guoqinghao/SmartCar/SC-Code/平衡车FreeRTOS/readme.txt

接线说明
编码器1:    PA0 PA1
编码器2:    PB6 PB7
陀螺仪:     SCL PC8
            SDA PC9
            AD0 PC7
            INT  PC6
PWM1,2:     PA6 PA7 
PWM3,4:     PB0 PB1
电压检测:   PC4
电机检测:   PA2
开机锁定:   PA3
串口TXD1:   PA9
串口RXD1:   PA10
串口TXD2:   PD5
串口RXD2:   PD6
串口TXD3:   PB10
串口RXD3:   PB11
按键中断:   PA4
心跳LED:    PA5
