guoqinghao/SmartCar/SC-PCB/Smart-Car-Core/Smart-Car.xlsx

 | Comment | Description | Designator | Footprint | LibRef | Quantity
 | 0.1μF | 0.1μF_50V,X7R,±5% | C1, C2, C3, C4, C5, C6, C9, C11, C13, C14, C15, C17, C23, C25, C35, C44, C56 | 0603C | Cap_0.1μF_50V_0603 | 17
 | 20pF | 20pF_50V,CH,±5% | C7, C8 | 0603C | Cap_20pF_50V_0603 | 2
 | 10μF | 10μF_35V,X5R,20% | C10, C12, C16, C22, C30, C32, C33, C39, C41, C42, C65 | 0603C | Cap_10μF_35V_0603 | 11
 | 39pF | 39pF_50V,C0G (EIA),±1% | C18, C20, C46, C52, C54, C59 | 0603C | Cap_39pF_50V_0603 | 6
 | 2.2μF | 2.2μF_35V,±10% | C19 | 0603C | Cap_2.2uF_35V_0603 | 1
 | 10nF | 10nF_50V,SL_0603,±5%, 10nF/16V,0603 | C21, C38 | 0603C | Cap_10nF_50V_0603, Cap_10nF_16V_0603 | 2
 | 0.01μF | 0.01μF_50V,C0G,5% | C24, C36, C45 | 0603C | Cap_0.01μF_50V_0603 | 3
 | 10μF | 10μF_10V,10% | C26 | 1206C | Cap_10μF_10V_1206 | 1
 | 4.7μF | 4.7μF_35VJB,±10% | C27, C28 | 1206C | Cap_4.7μF_35V_1206 | 2
 | 100μF | 100μF_16V | C29 | D7343C | Cap_100μF_16V_D7343 | 1
 | 470pf | 470pf_50V,X7R,10% | C31, C34, C40, C43 | 0603C | Cap_470pf_50V_0603 | 4
 | 100nf | 100nf_50V,X5R,10% | C37 | 0603C | Cap_100nf_50V_0603 | 1
 | 1μF | 1μF_50V,X5R,±10% | C47, C48, C49, C50, C51, C53, C55, C57, C58, C60, C61, C63, C64, C66 | 0603C | Cap_1μF_50V_0603 | 14
 | 0.15μF | 0.15μF_50V,X7R,±5% | C62 | 0603C | Cap_0.15μF_50V_0603 | 1
 | 蓝色LED | 蓝色LED | D1, D7 | 0603LED | 蓝色LED | 2
 | 1N5822 SS34 | 1N5822 SS34 | D2 | SMA-small | 1N5822 SS34_SMA | 1
 | 绿色LED | 蓝色LED | D3 | 0603LED | 蓝色LED | 1
 | 1N4148 | 1N4148WS | D4, D5 | SOD323 | 1N4148WS_SOD323 | 2
 | 红色LED | 蓝色LED | D6 | 0603LED | 蓝色LED | 1
 | 1N5819 SS14 | 1N5819 SS14 | D8 | SMA-small | 1N5819 SS14_SMA | 1
 | ESD5Z5.0T1G | ESD5Z5.0T1G | ESD1, ESD2, ESD6, ESD7, ESD8, ESD9 | SOD523 | ESD5Z5.0T1G_SOD523 | 6
 | ESD5Z6.0T1G | ESD5Z6.0T1G | ESD3, ESD5 | SOD523 | ESD5Z6.0T1G_SOD523 | 2
 | ESD5Z3.3T1G | ESD5Z3.3T1G | ESD4 | SOD523 | ESD5Z3.3T1G_SOD523 | 1
 | 轻触按键贴片 6*6*5 | 轻触按键贴片 6*6*5 | K1 | 轻触按键贴片 6*6*5 | 轻触按键贴片 6*6*5 | 1
 | BEAD-220/100MHZ | BEAD-220/100MHZ | L1, L2 | 0603R | BEAD-220/100MHZ_0603 | 2
 | 10μH_4A_7*7*3 | 10μH_4A | L3 | 7*7*3mm - 06030 | 10μH_4A_7*7*3 | 1
 | Header 5 | Header, 5-Pin | P1 | HDR1X5 | Header 5 | 1
 | Header 6 | Header, 6-Pin | P2, P3 | HDR1X6 | Header 6 | 2
 | Header 3 | Header, 3-Pin | P4 | HDR1X3 | Header 3 | 1
 | Header 2 | Header, 2-Pin | P5, P11 | HDR1X2 | Header 2 | 2
 | FPC-24P-0.5mm | FPC-24P-0.5mm | P6 | FPC24-0.5mm | FPC-24-0.5mm | 1
 | CA-C03 | CA-C03 | P8 | ANT | CA-C03 | 1
 | 预留测试口-2Pin | 预留测试口-2Pin | P9 | 预留测试口 2Pin | 预留测试口-2Pin | 1
 | Mini SD | Mini SD | P10 | TF-tan | Mini SD | 1
 | SI2323DS | SI2323DS | Q1 | SOT-23 | SI2323DS | 1
 | MMBT3904 | MMBT3904 | Q2 | SOT-23 | MMBT3904 | 1
 | 10K ohm | 10K ohm,1% | R1, R2, R3, R14, R18, R21, R22, R23, R27, R30, R47 | 0603R | Res_10K ohm_0603 | 11
 | 1M ohm | 1M ohm,1% | R4 | 0603R | Res_1M ohm_0603 | 1
 | 0 ohm | 0 ohm,5% | R5, R6, R7, R37, R50, R51 | 0603R | Res_0 ohm_0603 | 6
 | 4.7K ohm | 4.7K ohm,1% | R8, R11 | 0603R | Res_4.7K ohm_0603 | 2
 | 120ohm | 120 ohm_5% | R9, R12, R13, R16 | 0603R | Res_120ohm_0603 | 4
 | 200K ohm | 200K ohm,1% | R10 | 0603R | Res_200K ohm_0603 | 1
 | 68K ohm | 68K ohm,1% | R15 | 0603R | Res_68K ohm_0603 | 1
 | 100ohm | 100 ohm_5% | R17, R19, R36, R38, R41, R42 | 0603R | Res_100ohm_0603 | 6
 | 1K ohm | 1K ohm,1% | R20, R29, R32, R35, R40 | 0603R | Res_1K ohm_0603 | 5
 | 3K ohm | 3K ohm,1% | R24 | 0603R | Res_3K ohm_0603 | 1
 | 240ohm | 240ohm,1% | R25 | 0603R | Res_240ohm_0603 | 1
 | 100Kohm | 100K ohm_1%, 100K ohm_5% | R26, R31, R33 | 0603R | Res_100Kohm_0603 | 3
 | 330K ohm | 330K ohm,1% | R28, R34 | 0603R | Res_330K ohm_0603 | 2
 | 22K ohm | 22K ohm,1% | R39 | 0603R | Res_22K ohm_0603 | 1
 | 3.3K ohm | 3.3K ohm,1% | R43, R44, R45 | 0603R | Res_3.3K ohm_0603 | 3
 | 4.7ohm | 4.7ohm,1% | R46 | 0603R | Res_4.7ohm_0603 | 1
 | 39K ohm | 39K ohm,1% | R48 | 0603R | Res_39K ohm_0603 | 1
 | 0 ohm | 0 ohm,5% | R49 | 0805R | Res_0 ohm_0805 | 1
主芯片 | STM32F103VET6 | STM32F103VET6 | U1 | LQFP100 | STM32F103VET6 | 1
陀螺仪芯片 | MPU6050 | MPU6050 | U2 | QFN24 | MPU6050 | 1
 | DRV8833PWPR | DRV8833PWPR | U3 | TSSOP16 | DRV8833PWPR | 1
 | TPS5430DDAR | TPS5430DDAR | U4 | SOIC8-PAD | TPS5430DDAR | 1
 | TP2019-3.3YN5 | TP2019-3.3YN5 | U5, U6 | SOT-23-5 | TP2019-3.3YN5 | 2
 | KT1025A | KT1025A | U7 | SSOP24 | KT1025A | 1
 | BY8002-24SS | BY8002-24SS | U8 | QSOP-24N | BY8002-24SS | 1
 | MIX2002 | MIX2002 | U9 | SOP8 - NO-HP | MIX2002 | 1
 | XTAL_8MHz_5032 | XTAL_8MHz | Y1 | 5032 | XTAL_8MHz_5032 | 1
 | M49SMD-24M | M49SMD-24M | Y2 | M49S | M49SMD-24M-10ppm | 1
电机 | N20
