guoqinghao/SmartCar/SC-Model/PCB/Smart-Car.step

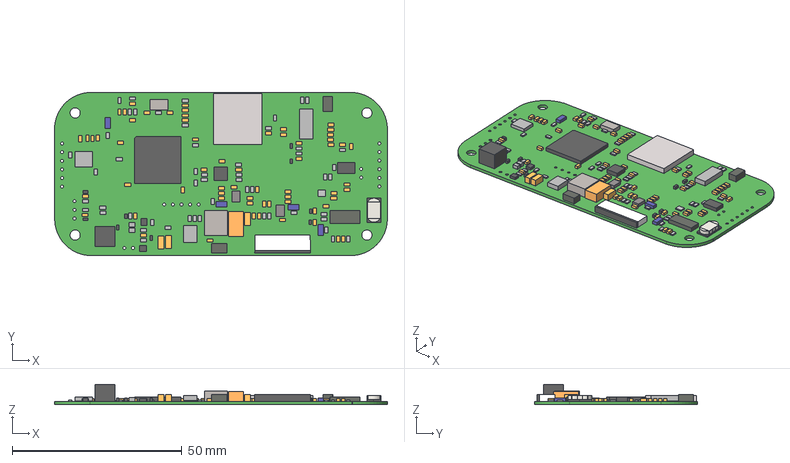
[picture p1: CAD file, 2023-08-29]
SC-Model/PCB/Smart-Car.step
98.2 x 48.1 x 6.00 mm
Extruded x 155
