guoqinghao/SmartCar/(list of files, drawings)

Other design files:
SC-PCB/SC_by_Iceda/Extend.SchDoc
SC-PCB/SC_by_Iceda/KT1025A.SchDoc
SC-PCB/SC_by_Iceda/MCU.SchDoc
SC-PCB/SC_by_Iceda/Module.SchDoc
SC-PCB/SC_by_Iceda/Power.SchDoc
SC-PCB/SC_by_Iceda/Smart-Car.PcbDoc
SC-PCB/SC_by_Iceda/Voice.SchDoc
SC-PCB/Smart-Car-Board/Extend.SchDoc
SC-PCB/Smart-Car-Board/Smart-Car.PrjPcb
SC-PCB/Smart-Car-Core/Extend.SchDoc
SC-PCB/Smart-Car-Core/KT1025A.SchDoc
SC-PCB/Smart-Car-Core/MCU.SchDoc
SC-PCB/Smart-Car-Core/Module.SchDoc
SC-PCB/Smart-Car-Core/Power.SchDoc
SC-PCB/Smart-Car-Core/Smart-Car.PrjPcb
SC-PCB/Smart-Car-Core/Voice.SchDoc
