guoqinghao/SmartCar/SC-Code/平衡车FreeRTOS/HARDWARE/MY_TASK/my_task.h

#ifndef __MY_TASK_H
#define __MY_TASK_H	 
#include "pbdata.h"
//*******任务优先级0-31,越大越优先*******************
#define START_TASK_PRIO		    1        
#define LED_TASK_PRIO		      2
#define UI_TASK_PRIO		      3
#define SPEED_TASK_PRIO		    3
#define MOTO_TASK_PRIO		    3
#define API_TASK_PRIO		      2
#define APITIME_TASK_PRIO     2
//*******任务堆栈大小	单位字 *4的单位为字节 1024字节为1KB**********
#define START_STK_SIZE 		50     
#define LED_STK_SIZE 		  500  
#define UI_STK_SIZE       500  
#define SPEED_STK_SIZE    500 
#define MOTO_STK_SIZE 		500  
#define API_STK_SIZE 		  50 
#define APITIME_STK_SIZE 	50 
//****查询任务状态****************
extern char task_buff[500];    //存储表格信息
extern char task_time_buff[500];
//********任务句柄*******************
extern TaskHandle_t StartTask_Handler;     
extern TaskHandle_t LEDTask_Handler;
extern TaskHandle_t UITask_Handler;
extern TaskHandle_t SPEEDTask_Handler;
extern TaskHandle_t MOTOTask_Handler;
extern TaskHandle_t APITask_Handler;
extern TaskHandle_t APITIMETask_Handler;
//********任务函数*******************
void FreeRTOS_Task_Start(void);
void start_task(void *pvParameters);
void led_task(void *pvParameters);
void ui_task(void *pvParameters);	
void speed_task(void *pvParameters);	
void moto_task(void *pvParameters);	
void api_task(void *pvParameters);
void apitime_task(void *pvParameters);
#endif
